yrys5/wearable-respiratory-monitoring-system/pcb/Manufacturing/main_controller-BOM.csv

Reference | Qty | Value | DNP | Exclude from BOM | Exclude from Board | Footprint | Datasheet | Distributor Link | Manufacturer | Manufacturer_Part_Number | Opis
AE1 | 1 | Antenna_Chip |  |  |  | SamacSys_Parts:ANT3216LL00R2400A | ~ | https://www.mouser.pl/ProductDetail/Pulse-Electronics/ANT3216LL00R2400A?qs=VAB4DzKv5wVywAIgVVebaA%3D%3D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 | Pulse Electronics | ANT3216LL00R2400A | Ceramic chip antenna with pin for PCB trace
C1,C2,C3,C4,C5,C6,C9,C10,C15,C16,C18,C21,C22,C23,C26,C27,C29,C30,C31 | 19 | 100n |  |  |  | Capacitor_SMD:C_0402_1005Metric | ~ | https://www.mouser.pl/ProductDetail/KYOCERA-AVX/04023C104KAT2A?qs=nNezP%252BoerbAsgsxxIAjFOw%3D%3D | KYOCERA AVX | 04023C104KAT2A | Unpolarized capacitor
C7,C8,C32,C33 | 4 | 4u7 |  |  |  | Capacitor_SMD:C_0603_1608Metric | ~ | https://www.mouser.pl/ProductDetail/KYOCERA-AVX/0603YD475MAT2A?qs=XLNwXgtzMM9JmbhKJE1Phg%3D%3D | KYOCERA AVX | 0603YD475MAT2A | Unpolarized capacitor
C11,C12 | 2 | 10p |  |  |  | Capacitor_SMD:C_0402_1005Metric | ~ | https://www.mouser.pl/ProductDetail/KYOCERA-AVX/04025A100JAT4A?qs=ZwvTZoB9SO9xQJ735IqqZg%3D%3D | KYOCERA AVX | 04025A100JAT4A | Unpolarized capacitor
C13 | 1 | NF |  |  |  | Capacitor_SMD:C_0402_1005Metric | ~ | https://www.mouser.pl/ProductDetail/KYOCERA-AVX/04023A102KAT2A?qs=zIdJ9r3ONKRWf%2FnwhLKx7Q%3D%3D | KYOCERA AVX | 04023A102KAT2A | Unpolarized capacitor
C14 | 1 | 1p2 |  |  |  | Capacitor_SMD:C_0402_1005Metric | ~ | https://www.mouser.pl/ProductDetail/KYOCERA-AVX/04025U1R2CAT2A?qs=ZwvTZoB9SO89N0yz92cnjQ%3D%3D | KYOCERA AVX | 04025U1R2CAT2A | Unpolarized capacitor
C17,C24 | 2 | 680p |  |  |  | Capacitor_SMD:C_0402_1005Metric | ~ | https://www.mouser.pl/ProductDetail/KYOCERA-AVX/KGM05ACG1H681JH?qs=Jm2GQyTW%2Fbi1QcZ9ve4RLw%3D%3D | KYOCERA AVX | KGM05ACG1H681JH | Unpolarized capacitor
C19,C20,C25,C28,C34 | 5 | 100p |  |  |  | Capacitor_SMD:C_0402_1005Metric | ~ | https://www.mouser.pl/ProductDetail/KYOCERA-AVX/KGM05ACG1E101JH?qs=OcgtsXO%252B3gsKy01JU7hIlA%3D%3D | KYOCERA AVX | KGM05ACG1E101JH | Unpolarized capacitor
FL1 | 1 | MLPF-WB55-01E3 |  |  |  | SamacSys_Parts:BUMPLESS_CSP_2025 | https://www.st.com/resource/en/datasheet/mlpf-wb55-01e3.pdf | https://www.mouser.pl/ProductDetail/STMicroelectronics/MLPF-WB55-01E3?qs=vLWxofP3U2xV%2FkxL9PmCDA%3D%3D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 | STMicroelectronics | MLPF-WB55-01E3 | 2.4 GHz low pass filter matched to STM32WB55Cx/Rx, STM32WB50Cx, STM32WB35Cx and STM32WB30Cx
FM1,FM2,FM3,FM4,FM5,FM6 | 6 | Fiducial |  | Excluded from BOM |  | Fiducial:Fiducial_1mm_Mask2mm | ~ |  |  |  | Fiducial Marker
IC1,IC2 | 2 | NAU7802SGI |  |  |  | SamacSys_Parts:SOIC127P600X175-16N | https://www.nuvoton.com/resource-files/NAU7802%20Data%20Sheet%20V1.7.pdf | https://www.mouser.pl/ProductDetail/Nuvoton/NAU7802SGI?qs=A6eO%252BMLsxmSrxisJRahwRQ%3D%3D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 | Nuvoton | NAU7802SGI | 24 Bit Analog to Digital Converter 2 Input 1 Sigma-Delta 16-SOP
IC6 | 1 | USBLC6-2SC6 |  |  |  | SamacSys_Parts:SOT95P280X145-6N | https://www.st.com/resource/en/datasheet/usblc6-2.pdf | https://www.mouser.pl/ProductDetail/STMicroelectronics/USBLC6-2SC6?qs=po45yt2pPpu%2FhNIlwQdTlg%3D%3D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 | STMicroelectronics | USBLC6-2SC6 | TVS Diode Array Uni-Directional USBLC6-2SC6 17V, SOT-23 6-Pin
J1 | 1 | USB_C_16P |  |  |  | Connector_USB:USB_C_Receptacle_GCT_USB4105-xx-A_16P_TopMnt_Horizontal | https://www.usb.org/sites/default/files/documents/usb_type-c.zip | https://www.mouser.pl/ProductDetail/GCT/USB4105-GF-A?qs=KUoIvG%2F9IlY%2FMLlBMpStpA%3D%3D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 | GCT | USB4105-GF-A | USB 2.0-only 16P Type-C Receptacle connector
J2 | 1 | TC2030 |  | Excluded from BOM |  | Connector:Tag-Connect_TC2030-IDC-FP_2x03_P1.27mm_Vertical | https://www.tag-connect.com/wp-content/uploads/bsk-pdf-manager/TC2030-CTX_1.pdf |  |  |  | Tag-Connect ARM Cortex SWD JTAG connector, 6 pin
J3,J4 | 2 | Screw_01x04 |  |  |  | SamacSys_Parts:2828374 | ~ | https://www.mouser.pl/ProductDetail/TE-Connectivity/282837-4?qs=A%252Bip%252BNCYi6MiQzbqNH27Ug%3D%3D | TE Connectivity | 282837-4 | Generic screw terminal, single row, 01x04, script generated (kicad-library-utils/schlib/autogen/connector/)
L1 | 1 | 3n6 |  |  |  | Inductor_SMD:L_0402_1005Metric | ~ | https://www.mouser.pl/ProductDetail/Murata-Electronics/LQG15HH3N6S02D?qs=%2F%252BYoplLUB5gB2r1QYGu9rQ%3D%3D | Murata Electronics | LQG15HH3N6S02D | Inductor
LED1 | 1 | BLUE |  |  |  | LED_SMD:LED_0603_1608Metric | ~ | https://www.mouser.pl/ProductDetail/Wurth-Elektronik/150040BS73240?qs=fAHHVMwC%252BbhvR%252BdBIVVrgw%3D%3D | Wurth Elektronik | 150040BS73240 | Light emitting diode
LED2 | 1 | GREEN |  |  |  | LED_SMD:LED_0603_1608Metric | ~ | https://www.mouser.pl/ProductDetail/Wurth-Elektronik/150040GS73240?qs=fAHHVMwC%252Bbgmx0FZHKuCJg%3D%3D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 | Wurth Elektronik | 150040GS73240 | Light emitting diode
LED3 | 1 | RED |  |  |  | LED_SMD:LED_0603_1608Metric | ~ | https://www.mouser.pl/ProductDetail/Wurth-Elektronik/150040RS73240?qs=8Aam6%252B7C6HGMiInmnlrBiw%3D%3D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 | Wurth Elektronik | 150040RS73240 | Light emitting diode
R1 | 1 | 2k |  |  |  | Resistor_SMD:R_0402_1005Metric | ~ | https://www.mouser.pl/ProductDetail/YAGEO/RC0402JR-072KP?qs=qpJ%252B%252B%252Bdg6p0PgyEL%2F3YtPQ%3D%3D | YAGEO | RC0402JR-072KP | Resistor
R2,R4 | 2 | 5k1 |  |  |  | Resistor_SMD:R_0402_1005Metric | ~ | https://www.mouser.pl/ProductDetail/YAGEO/RC0402FR-075K1L?qs=YUgVZYePFqCSmQuaha43RA%3D%3D | YAGEO | RC0402FR-075K1L | Resistor
R3,R6,R14,R15,R16,R17 | 6 | 100 |  |  |  | Resistor_SMD:R_0402_1005Metric | ~ | https://www.mouser.pl/ProductDetail/YAGEO/RC0402FR-7D100RL?qs=HEu%2FF%2FCqxzJsiV2ODdo2Ug%3D%3D | YAGEO | RC0402FR-7D100RL | Resistor
R5,R7,R11,R12 | 4 | 51 |  |  |  | Resistor_SMD:R_0402_1005Metric | ~ | https://www.mouser.pl/ProductDetail/YAGEO/RC0402FR-0751RL?qs=tJ7dZ%2FiRbl1ePfckivGc%252Bg%3D%3D | YAGEO | RC0402FR-0751RL | Resistor
R8,R9,R10,R13 | 4 | 0 |  |  |  | Resistor_SMD:R_0402_1005Metric | ~ | https://www.mouser.pl/ProductDetail/YAGEO/RC0402JR-7D0RL?qs=HEu%2FF%2FCqxzIQvs7MZn9nkA%3D%3D | YAGEO | RC0402JR-7D0RL | Resistor
U1 | 1 | STM32WB55CGU6 |  |  |  | Package_DFN_QFN:QFN-48-1EP_7x7mm_P0.5mm_EP5.6x5.6mm | https://www.st.com/resource/en/datasheet/stm32wb55cg.pdf | https://www.mouser.pl/ProductDetail/STMicroelectronics/STM32WB55CGU6?qs=lYGu3FyN48eI3bRY%252B36gew%3D%3D | STMicroelectronics | STM32WB55CGU6 | STMicroelectronics Arm Cortex-M4 MCU, 1024KB flash, 256KB RAM, 64 MHz, 1.71-3.6V, 30 GPIO, UFQFPN48
U2 | 1 | MIC5365-3.3YD5 |  |  |  | Package_TO_SOT_SMD:TSOT-23-5 | https://ww1.microchip.com/downloads/aemDocuments/documents/APID/ProductDocuments/DataSheets/MIC5365-6-High-Performance-Single-150mA-LDO-DS20006605A.pdf | https://www.mouser.pl/ProductDetail/Microchip-Technology/MIC5365-3.3YD5-TR?qs=U6T8BxXiZAXzRinbbfZRrg%3D%3D | Microchip Technology | MIC5365-3.3YD5-TR | 150mA Low-dropout Voltage Regulator, Vout 3.3V, Vin up to 5.5V, TSOT-23-5
X1 | 1 | 32kHz768 |  |  |  | Crystal:Crystal_SMD_2012-2Pin_2.0x1.2mm | ~ | https://www.mouser.pl/ProductDetail/NDK/NX2012SA-32.768K-STD-MUB-1?qs=55YtniHzbhA%252B6%2Fl1MwFZaQ%3D%3D | NDK | NX2012SA-32.768K-STD-MUB-1 | Two pin crystal
X2 | 1 | 32MHz |  |  |  | Crystal:Crystal_SMD_2016-4Pin_2.0x1.6mm | ~ | https://www.mouser.pl/ProductDetail/NDK/NX2016SA-32M-EXS00A-CS06465?qs=w%2Fv1CP2dgqr82b0JjRnv4A%3D%3D | NDK | NX2016SA-32M-EXS00A-CS06465 | Four pin crystal, GND on pins 2 and 4
