yrys5/wearable-respiratory-monitoring-system/3d-models/LoadcellHook.FCStd

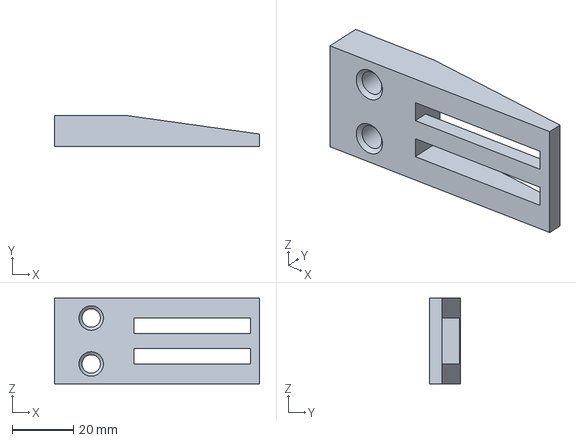
[picture p1: CAD file, 2026-10-22]
3d-models/LoadcellHook.FCStd
67.0 x 10.0 x 28.0 mm
