yrys5/wearable-respiratory-monitoring-system/3d-models/DeviceCaseBack_v2.FCStd

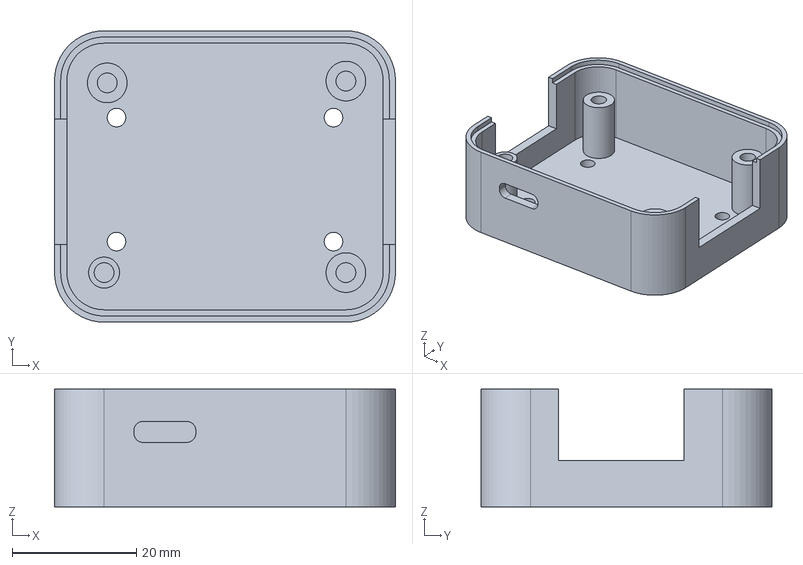
[picture p2: CAD file, 2026-10-22]
3d-models/DeviceCaseBack_v2.FCStd
55.0 x 47.0 x 19.0 mm
