yrys5/wearable-respiratory-monitoring-system/3d-models/LoadcellBack.FCStd

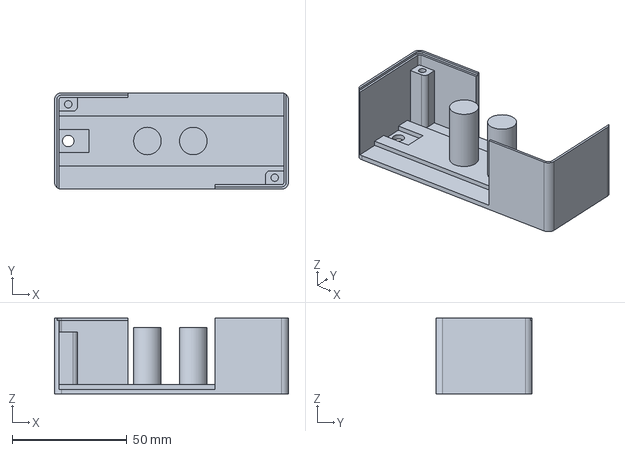
[picture p3: CAD file, 2026-10-22]
3d-models/LoadcellBack.FCStd
102.0 x 42.0 x 33.0 mm
