yrys5/wearable-respiratory-monitoring-system/3d-models/DeviceCaseFront_v2.FCStd

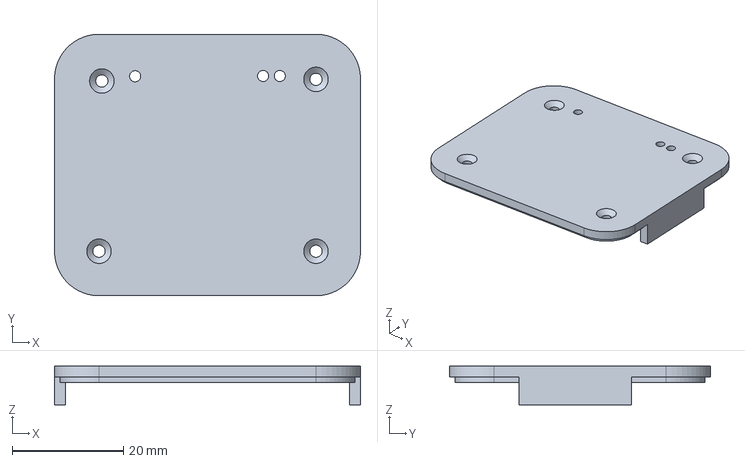
[picture p4: CAD file, 2026-10-22]
3d-models/DeviceCaseFront_v2.FCStd
55.0 x 47.0 x 7.00 mm
