yrys5/wearable-respiratory-monitoring-system/3d-models/LoadcellTop-Body.stl

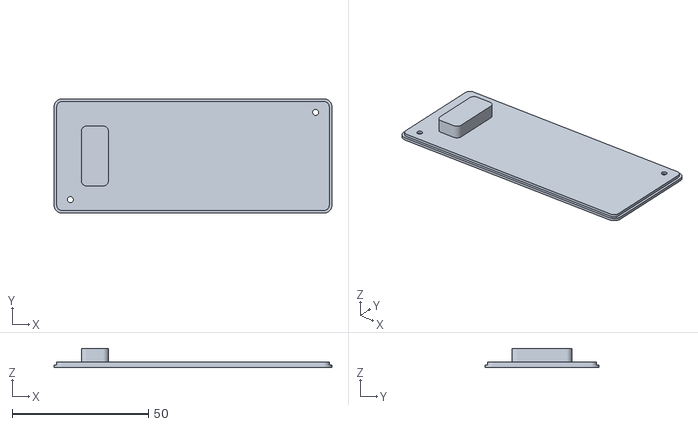
[picture p5: CAD file, 2026-10-22]
3d-models/LoadcellTop-Body.stl
102.0 x 42.0 x 7.00
