yrys5/wearable-respiratory-monitoring-system/(list of files, cad)

Other CAD files:
3d-models/LoadcellHook-Body.stl
3d-models/LoadcellBack-Body.stl
3d-models/DeviceCaseBack_v2-Body005.stl
3d-models/LoadcellTop.FCStd
3d-models/DeviceCaseFront_v2-Body006.stl
