yrys5/wearable-respiratory-monitoring-system/pcb/main_controller.kicad_pcb

## KiCad design pcb/main_controller.kicad_pcb (2026-10-22)

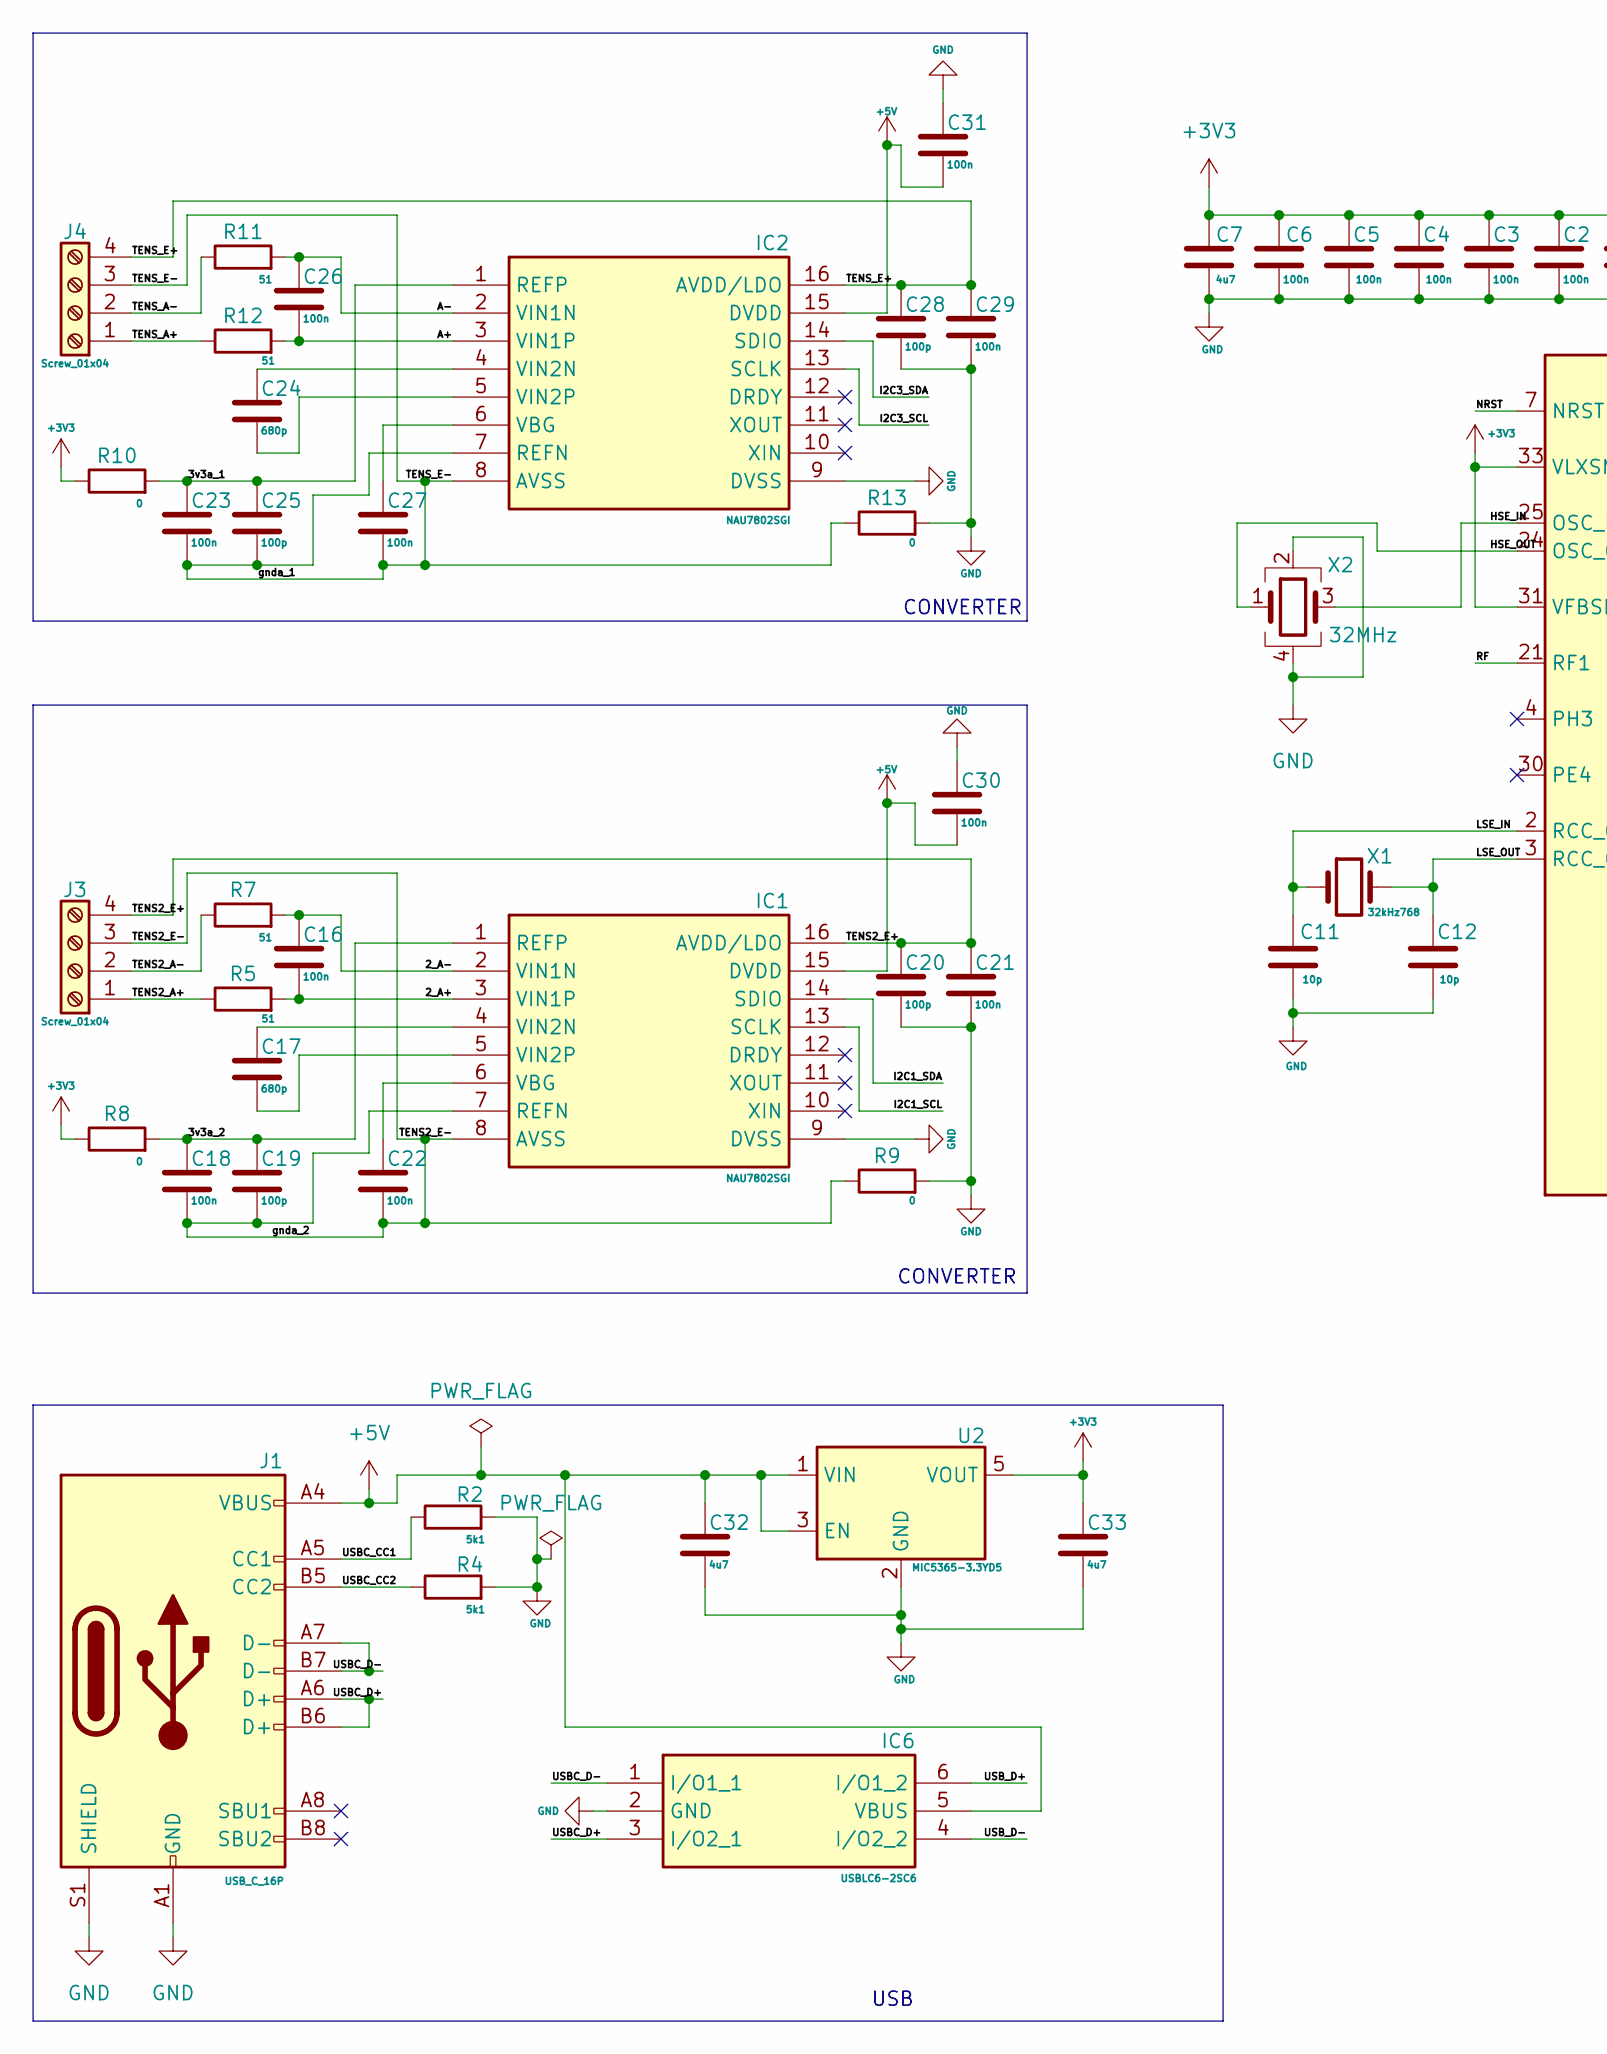
[picture p6: schematic main_controller.kicad_sch, part in row 1, column 1]

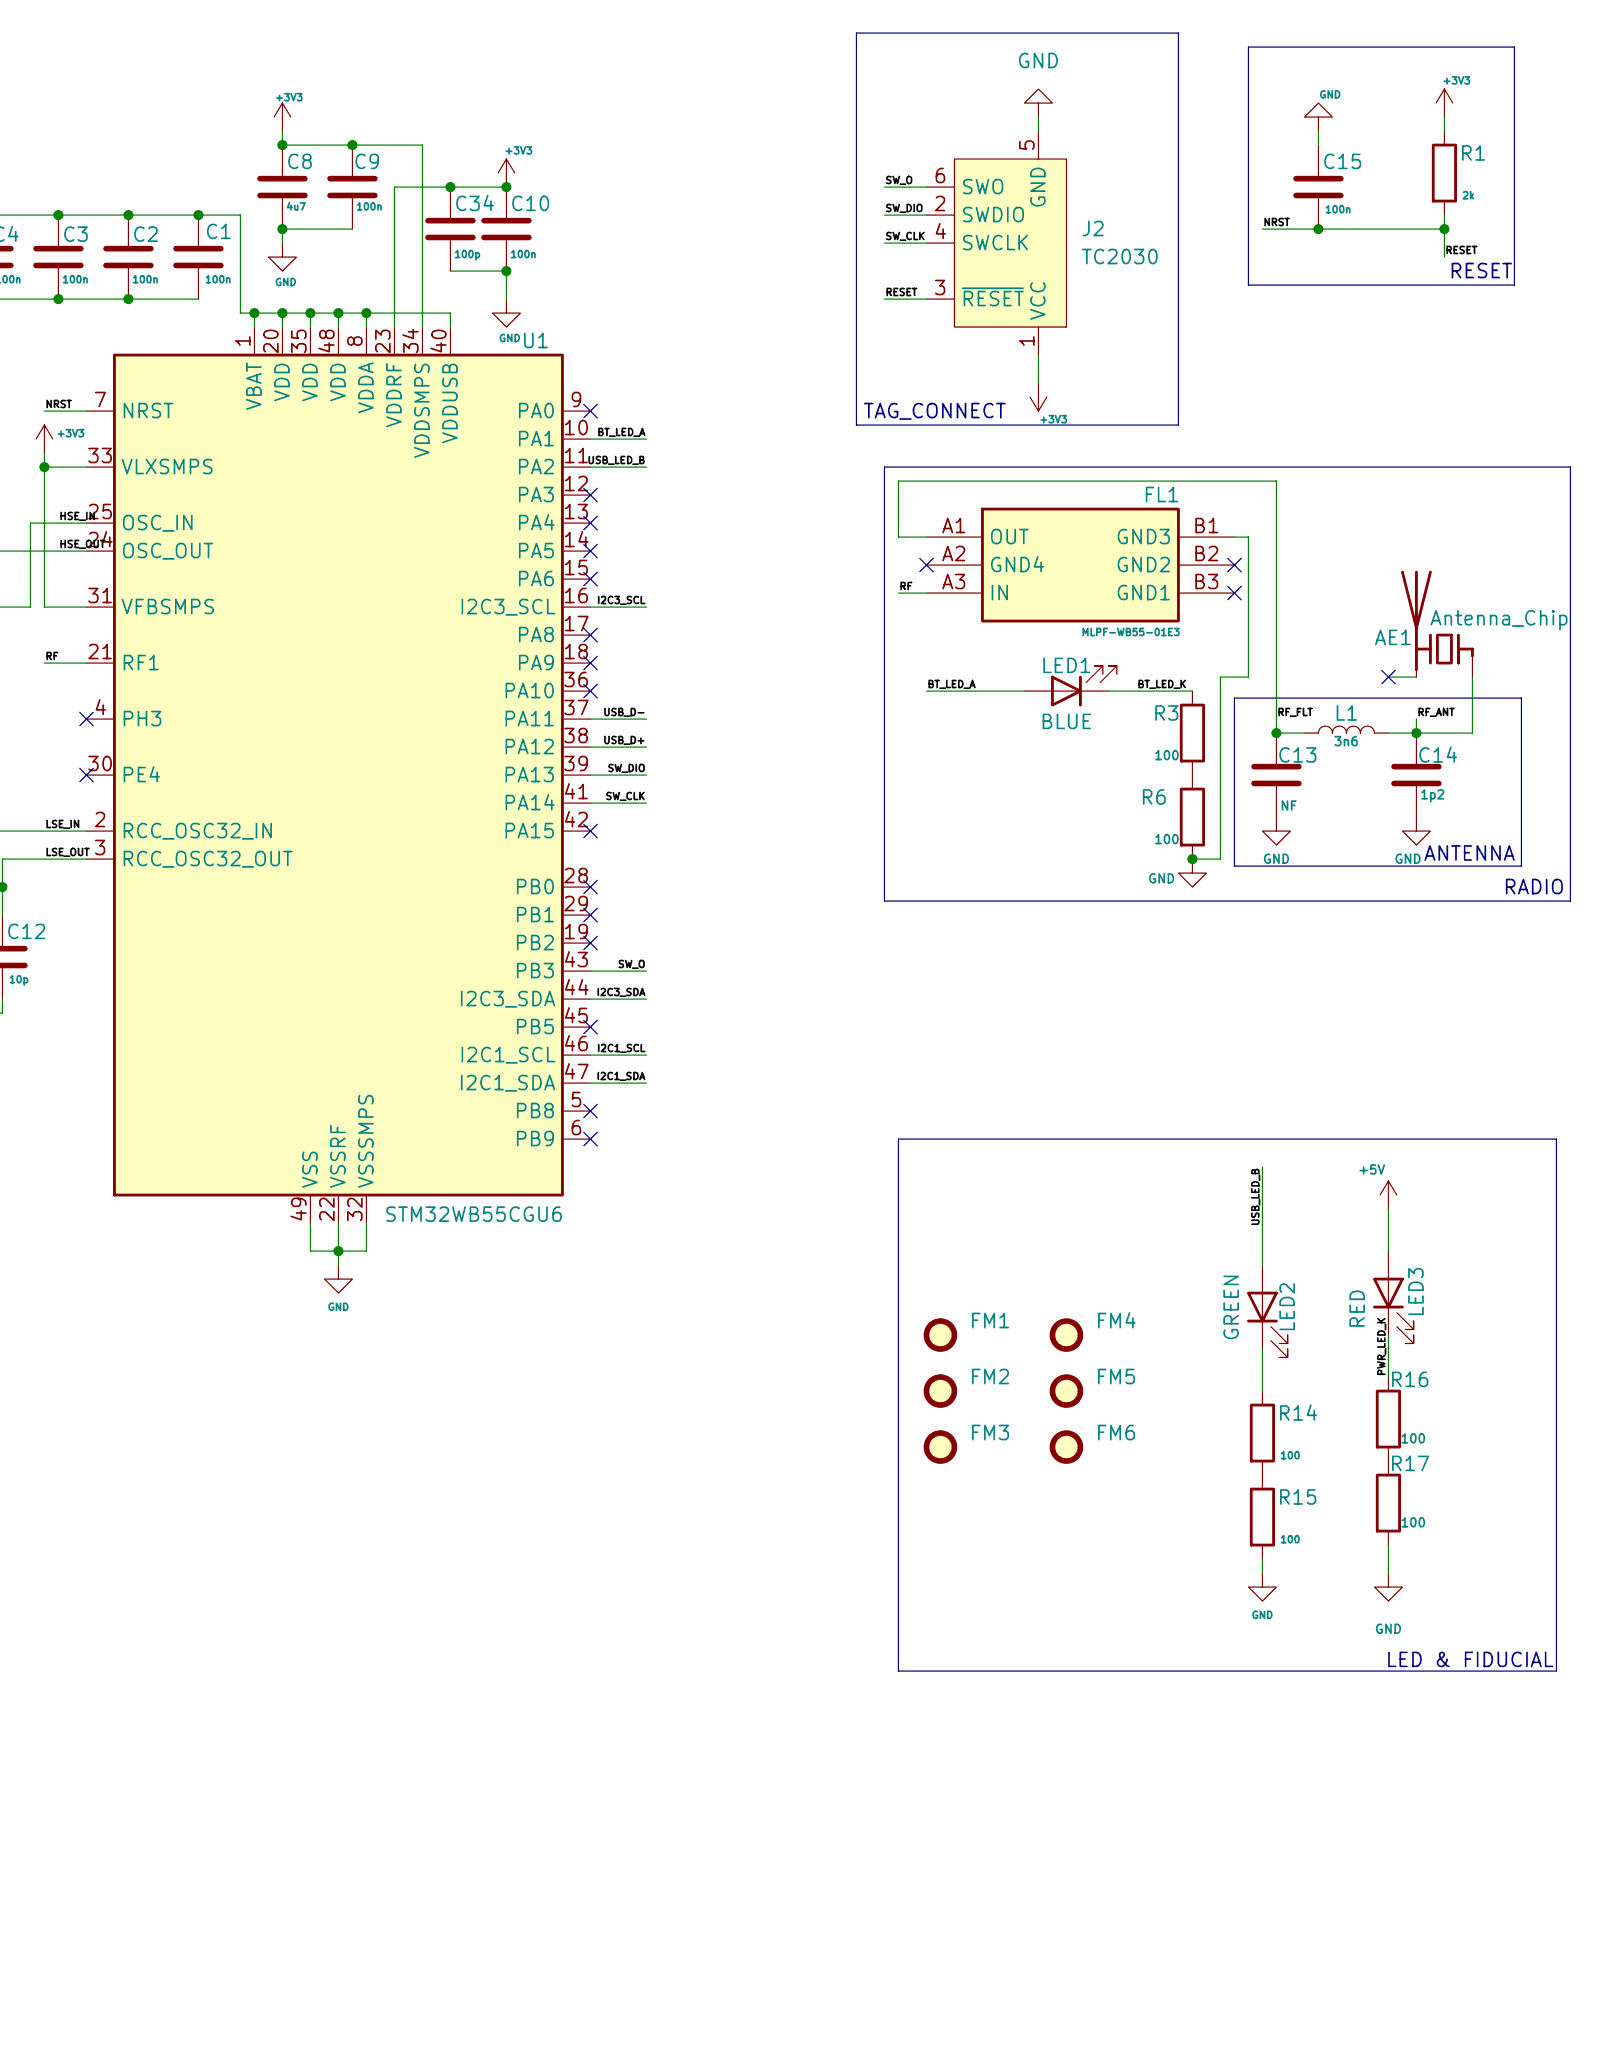
[picture p7: schematic main_controller.kicad_sch, part in row 1, column 2]

Parts:
AE1: Antenna_Chip; ANT3216LL00R2400A; Manufacturer_Part_Number ANT3216LL00R2400A
C1, C2, C3, C4, C5, C6, C9, C10, C15, C16, C18, C21, C22, C23, C26, C27, C29, C30, C31: 100n; C_0402_1005Metric; Manufacturer_Part_Number 04023C104KAT2A
C7, C8, C32, C33: 4u7; C_0603_1608Metric; Manufacturer_Part_Number 0603YD475MAT2A
C11, C12: 10p; C_0402_1005Metric; Manufacturer_Part_Number 04025A100JAT4A
C13: NF; C_0402_1005Metric; Manufacturer_Part_Number 04023A102KAT2A
C14: 1p2; C_0402_1005Metric; Manufacturer_Part_Number 04025U1R2CAT2A; DigiKey Number 490-6210-1-ND
C17, C24: 680p; C_0402_1005Metric; Manufacturer_Part_Number KGM05ACG1H681JH
C19, C20, C25, C28, C34: 100p; C_0402_1005Metric; Manufacturer_Part_Number KGM05ACG1E101JH
FL1: MLPF-WB55-01E3; BUMPLESS_CSP_2025; Mouser Part Number 511-MLPF-WB55-01E3
FM1, FM2, FM3, FM4, FM5, FM6: Fiducial; Fiducial_1mm_Mask2mm
IC1, IC2: NAU7802SGI; SOIC127P600X175-16N; Manufacturer_Part_Number NAU7802SGI
IC6: USBLC6-2SC6; SOT95P280X145-6N; Mouser Part Number 511-USBLC6-2SC6
J1: USB_C_16P; USB_C_Receptacle_GCT_USB4105-xx-A_16P_TopMnt_Horizontal; Manufacturer_Part_Number USB4105-GF-A
J2: TC2030; Tag-Connect_TC2030-IDC-FP_2x03_P1.27mm_Vertical
J3, J4: Screw_01x04; 2828374; Manufacturer_Part_Number 282837-4
L1: 3n6; L_0402_1005Metric; Manufacturer_Part_Number LQG15HH3N6S02D; DigiKey Number 490-6571-1-ND
LED1: BLUE; LED_0603_1608Metric; Manufacturer_Part_Number 150040BS73240
LED2: GREEN; LED_0603_1608Metric; Manufacturer_Part_Number 150040GS73240
LED3: RED; LED_0603_1608Metric; Manufacturer_Part_Number 150040RS73240; DigiKey Number 160-1447-1-ND
R1: 2k; R_0402_1005Metric; Manufacturer_Part_Number RC0402JR-072KP
R2, R4: 5k1; R_0402_1005Metric; Manufacturer_Part_Number RC0402FR-075K1L
R3, R6, R16, R17: 100; R_0402_1005Metric; Manufacturer_Part_Number RC0402FR-7D100RL; DigiKey Number 311-100JRCT-ND
R5, R7, R11, R12: 51; R_0402_1005Metric; Manufacturer_Part_Number RC0402FR-0751RL
R8, R9, R10, R13: 0; R_0402_1005Metric; Manufacturer_Part_Number RC0402JR-7D0RL
R14, R15: 100; R_0402_1005Metric; Manufacturer_Part_Number RC0402FR-7D100RL
U1: STM32WB55CGU6; QFN-48-1EP_7x7mm_P0.5mm_EP5.6x5.6mm; Manufacturer_Part_Number STM32WB55CGU6
U2: MIC5365-3.3YD5; TSOT-23-5; Manufacturer_Part_Number MIC5365-3.3YD5-TR
X1: 32kHz768; Crystal_SMD_2012-2Pin_2.0x1.2mm; Manufacturer_Part_Number NX2012SA-32.768K-STD-MUB-1
X2: 32MHz; Crystal_SMD_2016-4Pin_2.0x1.6mm; Manufacturer_Part_Number NX2016SA-32M-EXS00A-CS06465

Connections:
+3V3: C1.1, C2.1, C3.1, C4.1, C5.1, C6.1, C7.1, C8.1, C9.1, C10.1, C33.1, C34.1, J2.1 (VCC), R1.1, R8.1, R10.1, U1.1 (VBAT), U1.8 (VDDA), U1.20 (VDD), U1.23 (VDDRF), U1.31 (VFBSMPS), U1.33 (VLXSMPS), U1.34 (VDDSMPS), U1.35 (VDD), U1.40 (VDDUSB), U1.48 (VDD), U2.5 (VOUT)
+5V: C30.2, C31.2, C32.1, IC1.15 (DVDD), IC2.15 (DVDD), IC6.5 (VBUS), J1.A4 (VBUS), J1.A9 (VBUS), J1.B4 (VBUS), J1.B9 (VBUS), LED3.2 (A), U2.1 (VIN), U2.3 (EN)
/2_A+: C16.2, IC1.3 (VIN1P), R5.2
/2_A-: C16.1, IC1.2 (VIN1N), R7.2
/3v3a_1: C23.1, C25.1, IC2.1 (REFP), R10.2
/3v3a_2: C18.1, C19.1, IC1.1 (REFP), R8.2
/A+: C26.2, IC2.3 (VIN1P), R12.2
/A-: C26.1, IC2.2 (VIN1N), R11.2
/BT_LED_A: LED1.2 (A), U1.10 (PA1)
/BT_LED_K: LED1.1 (K), R3.1
/HSE_IN: U1.25 (OSC_IN), X2.3
/HSE_OUT: U1.24 (OSC_OUT), X2.1
/I2C1_SCL: IC1.13 (SCLK), U1.46 (I2C1_SCL)
/I2C1_SDA: IC1.14 (SDIO), U1.47 (I2C1_SDA)
/I2C3_SCL: IC2.13 (SCLK), U1.16 (I2C3_SCL)
/I2C3_SDA: IC2.14 (SDIO), U1.44 (I2C3_SDA)
/LSE_IN: C11.1, U1.2 (RCC_OSC32_IN), X1.1
/LSE_OUT: C12.1, U1.3 (RCC_OSC32_OUT), X1.2
/NRST: C15.2, J2.3 (~RESET), R1.2, U1.7 (NRST)
/PWR_LED_K: LED3.1 (K), R16.1
/RF: FL1.A3 (IN), U1.21 (RF1)
/RF_ANT: AE1.1 (FEED), C14.1, L1.2
/RF_FLT: C13.1, FL1.A1 (OUT), L1.1
/SW_CLK: J2.4 (SWCLK), U1.41 (PA14)
/SW_DIO: J2.2 (SWDIO), U1.39 (PA13)
/SW_O: J2.6 (SWO), U1.43 (PB3)
/TENS2_A+: J3.1, R5.1
/TENS2_A-: J3.2, R7.1
/TENS2_E+: C20.1, C21.1, IC1.16 (AVDD/LDO), J3.4
/TENS2_E-: C18.2, C19.2, C22.2, IC1.7 (REFN), IC1.8 (AVSS), J3.3, R9.1
/TENS_A+: J4.1, R12.1
/TENS_A-: J4.2, R11.1
/TENS_E+: C28.1, C29.1, IC2.16 (AVDD/LDO), J4.4
/TENS_E-: C23.2, C25.2, C27.2, IC2.7 (REFN), IC2.8 (AVSS), J4.3, R13.1
/USBC_CC1: J1.A5 (CC1), R2.1
/USBC_CC2: J1.B5 (CC2), R4.1
/USBC_D+: IC6.3 (I/O2_1), J1.A6 (D+), J1.B6 (D+)
/USBC_D-: IC6.1 (I/O1_1), J1.A7 (D-), J1.B7 (D-)
/USB_D+: IC6.6 (I/O1_2), U1.38 (PA12)
/USB_D-: IC6.4 (I/O2_2), U1.37 (PA11)
GND: C1.2, C2.2, C3.2, C4.2, C5.2, C6.2, C7.2, C8.2, C9.2, C10.2, C11.2, C12.2, C13.2, C14.2, C15.1, C20.2, C21.2, C28.2, C29.2, C30.1, C31.1, C32.2, C33.2, C34.2, FL1.B1 (GND3), IC1.9 (DVSS), IC2.9 (DVSS), IC6.2 (GND), J1.A1 (GND), J1.A12 (GND), J1.B1 (GND), J1.B12 (GND), J1.S1 (SHIELD), J2.5 (GND), R2.2, R4.2, R6.2, R9.2, R13.2, R15.2, R17.2, U1.22 (VSSRF), U1.32 (VSSSMPS), U1.49 (VSS), U2.2 (GND), X2.2, X2.4
unnamed: C22.1, IC1.6 (VBG)
unnamed: C17.1, IC1.4 (VIN2N)
unnamed: C17.2, IC1.5 (VIN2P)
unnamed: C27.1, IC2.6 (VBG)
unnamed: C24.1, IC2.4 (VIN2N)
unnamed: C24.2, IC2.5 (VIN2P)
unnamed: LED2.2 (A), U1.11 (PA2)
unnamed: LED2.1 (K), R14.1
unnamed: R3.2, R6.1
unnamed: R14.2, R15.1
unnamed: R16.2, R17.1

Notes on the sheet:
RADIO
CONVERTER
ANTENNA
TAG_CONNECT
RESET
USB
LED & FIDUCIAL

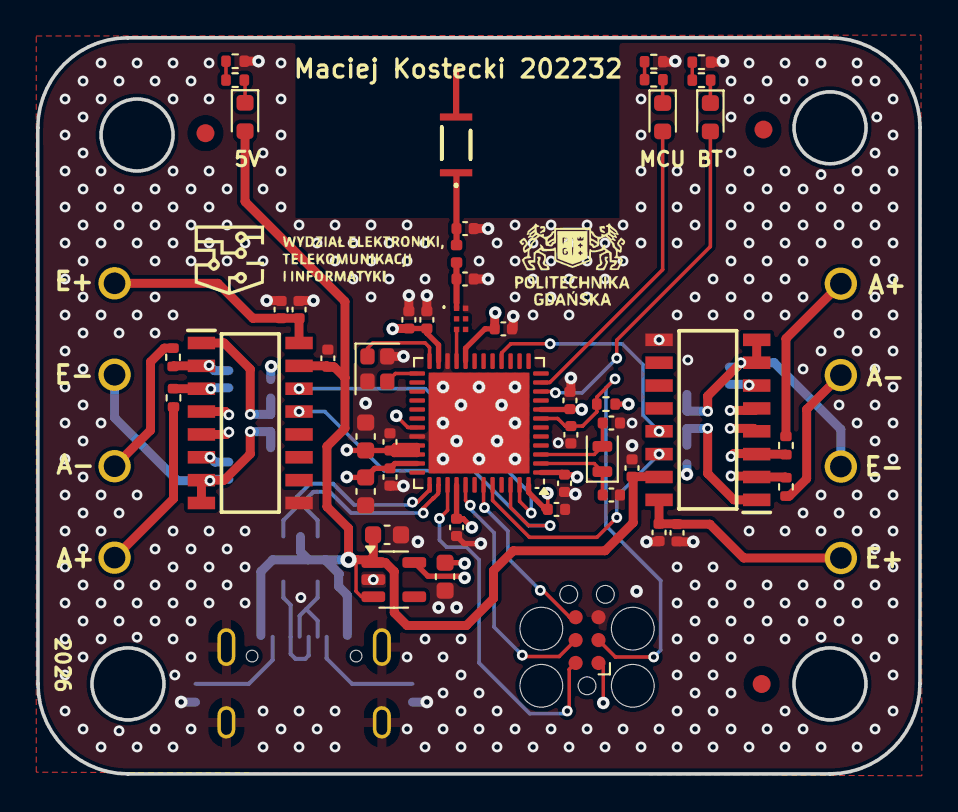
[picture p8: board main_controller.kicad_pcb from above]

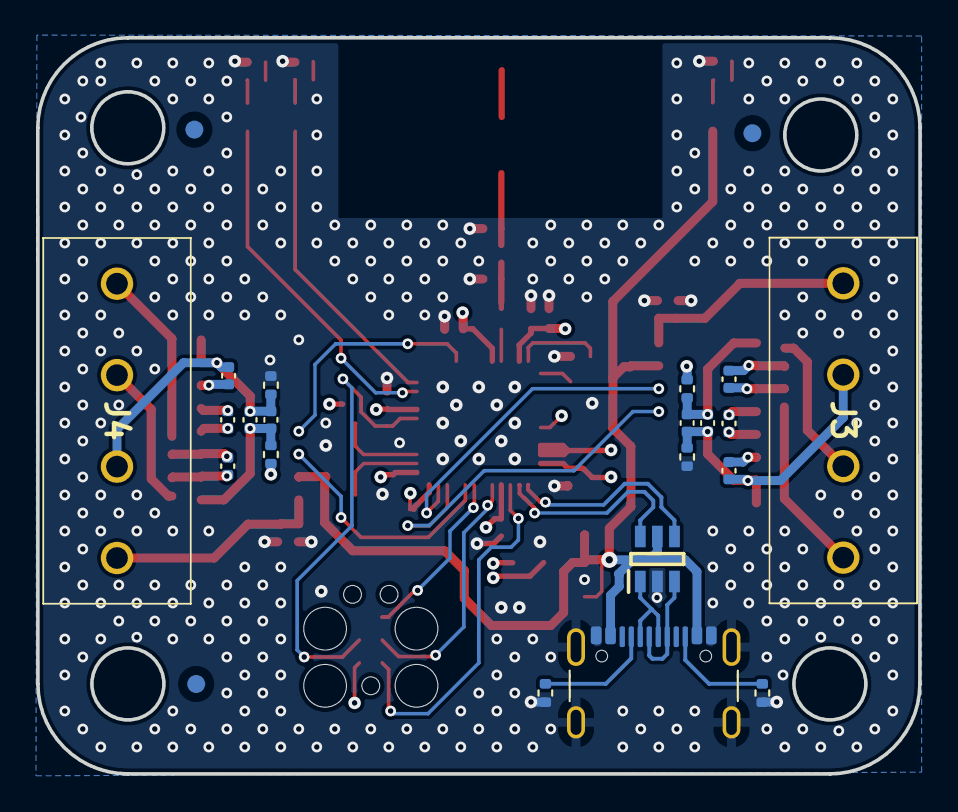
[picture p9: board main_controller.kicad_pcb from below]

Board: 4 copper layers, 49.0 x 40.9 mm, 74 parts (23 on the bottom side), 52 nets.
