yrys5/wearable-respiratory-monitoring-system/firmware/Src/main.c

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
/* Includes ------------------------------------------------------------------*/
#include "main.h"
#include "usb_device.h"

/* USER CODE BEGIN Includes */
#include "nau7802.h"
#include "custom_app.h"
/* USER CODE END Includes */

I2C_HandleTypeDef hi2c1;
I2C_HandleTypeDef hi2c3;

IPCC_HandleTypeDef hipcc;

RTC_HandleTypeDef hrtc;

/* USER CODE BEGIN PV */
NAU7802_HandleTypeDef nau1;
NAU7802_HandleTypeDef nau2;

int32_t nau1_raw = 0;
int32_t nau2_raw = 0;

uint8_t nau1_ok = 0;
uint8_t nau2_ok = 0;

volatile uint32_t nau1_read_ok_count = 0;
volatile uint32_t nau2_read_ok_count = 0;

volatile uint32_t nau1_read_error_count = 0;
volatile uint32_t nau2_read_error_count = 0;

volatile uint32_t nau1_not_ready_count = 0;
volatile uint32_t nau2_not_ready_count = 0;

volatile uint32_t main_loop_count = 0;

volatile uint32_t nau1_last_read_tick = 0;
volatile uint32_t nau2_last_read_tick = 0;

volatile uint32_t nau1_last_ok_tick = 0;
volatile uint32_t nau2_last_ok_tick = 0;

volatile uint32_t send_last_tick = 0;

static uint32_t consumed_ch1_count = 0;
static uint32_t consumed_ch2_count = 0;
//NAU7802_HandleTypeDef nau1;
//NAU7802_HandleTypeDef nau2;
//
//int32_t nau1_raw = 0;
//int32_t nau2_raw = 0;
//
//uint8_t nau1_ok = 0;
//uint8_t nau2_ok = 0;
//
//volatile uint32_t nau1_read_ok_count = 0;
//volatile uint32_t nau2_read_ok_count = 0;
//volatile uint32_t nau1_read_error_count = 0;
//volatile uint32_t nau2_read_error_count = 0;
//volatile uint32_t nau1_not_ready_count = 0;
//volatile uint32_t main_loop_count = 0;
//volatile uint32_t nau1_last_read_tick = 0;
//volatile uint32_t nau1_last_ok_tick = 0;
/* USER CODE END PV */

void SystemClock_Config(void);
void PeriphCommonClock_Config(void);
static void MX_GPIO_Init(void);
static void MX_I2C1_Init(void);
static void MX_I2C3_Init(void);
static void MX_IPCC_Init(void);
static void MX_RTC_Init(void);
static void MX_RF_Init(void);
/**
  * @brief  The application entry point.
  * @retval int
  */
int main(void)
{

  /* MCU Configuration--------------------------------------------------------*/

  /* Reset of all peripherals, Initializes the Flash interface and the Systick. */
  HAL_Init();
  /* Config code for STM32_WPAN (HSE Tuning must be done before system clock configuration) */
  MX_APPE_Config();

  /* Configure the system clock */
  SystemClock_Config();

  /* Configure the peripherals common clocks */
  PeriphCommonClock_Config();

  /* IPCC initialisation */
  MX_IPCC_Init();

  /* Initialize all configured peripherals */
  MX_GPIO_Init();
  MX_I2C1_Init();
  MX_I2C3_Init();
  MX_RTC_Init();
  MX_USB_Device_Init();
  MX_RF_Init();
  /* USER CODE BEGIN 2 */
  HAL_Delay(100);

  /*
   * ADC 1 - I2C1
   */
  if (NAU7802_Init(&nau1, &hi2c1) == NAU7802_OK)
  {
      nau1_ok = 1;
      NAU7802_DumpRegisters(&nau1);
  }
  else
  {
      nau1_ok = 0;
  }
  if (NAU7802_Init(&nau2, &hi2c3) == NAU7802_OK)
  {
      nau2_ok = 1;
      NAU7802_DumpRegisters(&nau2);
  }
  else
  {
      nau2_ok = 0;
  }
  /* USER CODE END 2 */

  /* Init code for STM32_WPAN */
  MX_APPE_Init();

  /* Infinite loop */
  /* USER CODE BEGIN WHILE */
  while (1)
  {
	     if ((HAL_GetTick() - nau1_last_read_tick) >= 100)
	     {
	         nau1_last_read_tick = HAL_GetTick();

	         if (nau1_ok)
	         {
	             NAU7802_Status result = NAU7802_ReadRawBlocking(&nau1, &nau1_raw, 50);

	             if (result == NAU7802_OK)
	             {
	                 nau1_read_ok_count++;
	                 nau1_last_ok_tick = HAL_GetTick();

	             }
	             else if (result == NAU7802_NOT_READY || result == NAU7802_TIMEOUT)
	             {
	                 nau1_not_ready_count++;
	             }
	             else
	             {
	                 nau1_read_error_count++;
	             }
	         }
	     }
		  if ((HAL_GetTick() - nau2_last_read_tick) >= 100)
		  {
		      nau2_last_read_tick = HAL_GetTick();

		      if (nau2_ok)
		      {
		          NAU7802_Status result = NAU7802_ReadRawBlocking(&nau2, &nau2_raw, 50);

		          if (result == NAU7802_OK)
		          {
		              nau2_read_ok_count++;
		              nau2_last_ok_tick = HAL_GetTick();

		          }
		          else if (result == NAU7802_NOT_READY || result == NAU7802_TIMEOUT)
		          {
		              nau2_not_ready_count++;
		          }
		          else
		          {
		              nau2_read_error_count++;
		          }
		      }
		  }
		  if ((HAL_GetTick() - send_last_tick) >= 100)
		  {
		      send_last_tick = HAL_GetTick();
              if(nau1_ok && nau2_ok &&
                 nau1_read_ok_count != consumed_ch1_count &&
                 nau2_read_ok_count != consumed_ch2_count) {
                  Custom_APP_SendAdcValue(nau1_raw, nau2_raw);
              } else {
                  Custom_APP_AdcGap();
              }
              consumed_ch1_count = nau1_read_ok_count;
              consumed_ch2_count = nau2_read_ok_count;
		  }
    /* USER CODE END WHILE */
    MX_APPE_Process();

    /* USER CODE BEGIN 3 */
    Custom_APP_Process();
  }
  /* USER CODE END 3 */
}

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
