yrys5/wearable-respiratory-monitoring-system/firmware/BA_WB_3.ioc

Mcu.UserName=STM32WB55CGUx
PA1.GPIO_Label=BL_LED_A
PA1.Signal=GPIO_Output
PA11.Signal=USB_DM
PA12.Signal=USB_DP
PA13.Signal=SYS_JTMS-SWDIO
PA14.Signal=SYS_JTCK-SWCLK
PA2.GPIO_Label=MCU_LED
PA2.Signal=GPIO_Output
PA7.Signal=I2C3_SCL
PB3.Signal=SYS_JTDO-SWO
PB4.Signal=I2C3_SDA
PB6.Signal=I2C1_SCL
PB7.Signal=I2C1_SDA
PC14-OSC32_IN.Signal=RCC_OSC32_IN
PC15-OSC32_OUT.Signal=RCC_OSC32_OUT
