yrys5/wearable-respiratory-monitoring-system/firmware/Inc/main.h

#define BL_LED_A_Pin GPIO_PIN_1
#define BL_LED_A_GPIO_Port GPIOA
#define MCU_LED_Pin GPIO_PIN_2
#define MCU_LED_GPIO_Port GPIOA
