yrys5/wearable-respiratory-monitoring-system/firmware/Src/custom_stm.c

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

/* Includes ------------------------------------------------------------------*/
#include "common_blesvc.h"
#include "custom_stm.h"

/* USER CODE BEGIN Includes */
#include "custom_app.h"
#include "main.h"
/* USER CODE END Includes */

typedef struct{
  uint16_t  CustomBaservHdle;                    /**< BrathingAnalyzerService handle */
  uint16_t  CustomBawb55Hdle;                  /**< BrathingAnalyzerWB55 handle */
/* USER CODE BEGIN Context */
  uint16_t ControlHdle;
/* USER CODE END Context */
}CustomContext_t;

extern uint16_t Connection_Handle;
#define UUID_128_SUPPORTED  1

#if (UUID_128_SUPPORTED == 1)
#define BM_UUID_LENGTH  UUID_TYPE_128
#else
#define BM_UUID_LENGTH  UUID_TYPE_16
#endif

#define BM_REQ_CHAR_SIZE    (3)

#define CHARACTERISTIC_DESCRIPTOR_ATTRIBUTE_OFFSET         2
#define CHARACTERISTIC_VALUE_ATTRIBUTE_OFFSET              1
uint16_t SizeBawb55 = 20;

/**
 * START of Section BLE_DRIVER_CONTEXT
 */
static CustomContext_t CustomContext;

/**
 * END of Section BLE_DRIVER_CONTEXT
 */

static SVCCTL_EvtAckStatus_t Custom_STM_Event_Handler(void *pckt);

static tBleStatus Generic_STM_App_Update_Char_Ext(uint16_t ConnectionHandle, uint16_t ServiceHandle, uint16_t CharHandle, uint16_t CharValueLen, uint8_t *pPayload);

/* Functions Definition ------------------------------------------------------*/

#define COPY_UUID_128(uuid_struct, uuid_15, uuid_14, uuid_13, uuid_12, uuid_11, uuid_10, uuid_9, uuid_8, uuid_7, uuid_6, uuid_5, uuid_4, uuid_3, uuid_2, uuid_1, uuid_0) \
do {\
    uuid_struct[0] = uuid_0; uuid_struct[1] = uuid_1; uuid_struct[2] = uuid_2; uuid_struct[3] = uuid_3; \
    uuid_struct[4] = uuid_4; uuid_struct[5] = uuid_5; uuid_struct[6] = uuid_6; uuid_struct[7] = uuid_7; \
    uuid_struct[8] = uuid_8; uuid_struct[9] = uuid_9; uuid_struct[10] = uuid_10; uuid_struct[11] = uuid_11; \
    uuid_struct[12] = uuid_12; uuid_struct[13] = uuid_13; uuid_struct[14] = uuid_14; uuid_struct[15] = uuid_15; \
}while(0)

#define COPY_BRATHINGANALYZERSERVICE_UUID(uuid_struct)          COPY_UUID_128(uuid_struct,0x00,0x00,0x00,0x00,0xcc,0x7a,0x48,0x2a,0x98,0x4a,0x7f,0x2e,0xd5,0xb3,0xe5,0x8f)
#define COPY_BRATHINGANALYZERWB55_UUID(uuid_struct)    COPY_UUID_128(uuid_struct,0x00,0x00,0xa0,0x01,0x8e,0x22,0x45,0x41,0x9d,0x4c,0x21,0xed,0xae,0x82,0xed,0x19)

/**
 * @brief  Event handler
 * @param  Event: Address of the buffer holding the Event
 * @retval Ack: Return whether the Event has been managed or not
 */
static SVCCTL_EvtAckStatus_t Custom_STM_Event_Handler(void *Event)
{
  SVCCTL_EvtAckStatus_t return_value;
  hci_event_pckt *event_pckt;
  evt_blecore_aci *blecore_evt;
  aci_gatt_attribute_modified_event_rp0 *attribute_modified;
  aci_gatt_read_permit_req_event_rp0    *read_req;
  aci_gatt_notification_complete_event_rp0    *notification_complete;
  Custom_STM_App_Notification_evt_t     Notification;
  return_value = SVCCTL_EvtNotAck;
  event_pckt = (hci_event_pckt *)(((hci_uart_pckt*)Event)->data);

  switch (event_pckt->evt)
  {
    case HCI_VENDOR_SPECIFIC_DEBUG_EVT_CODE:
      blecore_evt = (evt_blecore_aci*)event_pckt->data;
      switch (blecore_evt->ecode)
      {
        case ACI_GATT_ATTRIBUTE_MODIFIED_VSEVT_CODE:
          /* USER CODE BEGIN EVT_BLUE_GATT_ATTRIBUTE_MODIFIED_BEGIN */

          /* USER CODE END EVT_BLUE_GATT_ATTRIBUTE_MODIFIED_BEGIN */
          attribute_modified = (aci_gatt_attribute_modified_event_rp0*)blecore_evt->data;
          if (attribute_modified->Attr_Handle == (CustomContext.CustomBawb55Hdle + CHARACTERISTIC_DESCRIPTOR_ATTRIBUTE_OFFSET))
          {
            return_value = SVCCTL_EvtAckFlowEnable;
            switch (attribute_modified->Attr_Data[0])
            {
              /* USER CODE BEGIN CUSTOM_STM_Service_1_Char_1_attribute_modified  */

              /* USER CODE END CUSTOM_STM_Service_1_Char_1_attribute_modified  */

              /* Disabled Notification and Indication management */
              case (!(COMSVC_Notification) | !(COMSVC_Indication)):
                /* USER CODE BEGIN CUSTOM_STM_Service_1_Char_1_Disabled_BEGIN  */

                /* USER CODE END CUSTOM_STM_Service_1_Char_1_Disabled_BEGIN  */
                Notification.Custom_Evt_Opcode = CUSTOM_STM_BAWB55_NOTIFY_DISABLED_EVT;
                Custom_STM_App_Notification(&Notification);
                Notification.Custom_Evt_Opcode = CUSTOM_STM_BAWB55_INDICATE_DISABLED_EVT;
                Custom_STM_App_Notification(&Notification);
                /* USER CODE BEGIN CUSTOM_STM_Service_1_Char_1_Disabled_END */

                /* USER CODE END CUSTOM_STM_Service_1_Char_1_Disabled_END */
                break;

              /* Enabled Notification management */
              case COMSVC_Notification:
                /* USER CODE BEGIN CUSTOM_STM_Service_1_Char_1_COMSVC_Notification_BEGIN */

                /* USER CODE END CUSTOM_STM_Service_1_Char_1_COMSVC_Notification_BEGIN */
                Notification.Custom_Evt_Opcode = CUSTOM_STM_BAWB55_NOTIFY_ENABLED_EVT;
                Custom_STM_App_Notification(&Notification);
                /* USER CODE BEGIN CUSTOM_STM_Service_1_Char_1_COMSVC_Notification_END */

                /* USER CODE END CUSTOM_STM_Service_1_Char_1_COMSVC_Notification_END */
                break;

              /* Enabled Indication management */
              case COMSVC_Indication:
                /* USER CODE BEGIN CUSTOM_STM_Service_1_Char_1_COMSVC_Indication_BEGIN */

                /* USER CODE END CUSTOM_STM_Service_1_Char_1_COMSVC_Indication_BEGIN */
                Notification.Custom_Evt_Opcode = CUSTOM_STM_BAWB55_INDICATE_ENABLED_EVT;
                Custom_STM_App_Notification(&Notification);
                /* USER CODE BEGIN CUSTOM_STM_Service_1_Char_1_COMSVC_Indication_END */

                /* USER CODE END CUSTOM_STM_Service_1_Char_1_COMSVC_Indication_END */
                break;

              default:
                /* USER CODE BEGIN CUSTOM_STM_Service_1_Char_1_default */

                /* USER CODE END CUSTOM_STM_Service_1_Char_1_default */
                break;
            }
          }  /* if (attribute_modified->Attr_Handle == (CustomContext.CustomBawb55Hdle + CHARACTERISTIC_DESCRIPTOR_ATTRIBUTE_OFFSET))*/

          /* USER CODE BEGIN EVT_BLUE_GATT_ATTRIBUTE_MODIFIED_END */
          if(attribute_modified->Attr_Handle ==
             CustomContext.ControlHdle + CHARACTERISTIC_VALUE_ATTRIBUTE_OFFSET) {
            return_value=SVCCTL_EvtAckFlowEnable;
            /* Parse immediately: the event payload is not retained. No ACI call here. */
            Custom_APP_Control(attribute_modified->Attr_Data,
                               attribute_modified->Attr_Data_Length);
          }
/* USER CODE END EVT_BLUE_GATT_ATTRIBUTE_MODIFIED_END */
          break;

        case ACI_GATT_READ_PERMIT_REQ_VSEVT_CODE :
          /* USER CODE BEGIN EVT_BLUE_GATT_READ_PERMIT_REQ_BEGIN */

          /* USER CODE END EVT_BLUE_GATT_READ_PERMIT_REQ_BEGIN */
          read_req = (aci_gatt_read_permit_req_event_rp0*)blecore_evt->data;
          if (read_req->Attribute_Handle == (CustomContext.CustomBawb55Hdle + CHARACTERISTIC_VALUE_ATTRIBUTE_OFFSET))
          {
            return_value = SVCCTL_EvtAckFlowEnable;
            /*USER CODE BEGIN CUSTOM_STM_Service_1_Char_1_ACI_GATT_READ_PERMIT_REQ_VSEVT_CODE_1 */

            /*USER CODE END CUSTOM_STM_Service_1_Char_1_ACI_GATT_READ_PERMIT_REQ_VSEVT_CODE_1*/
            aci_gatt_allow_read(read_req->Connection_Handle);
            /*USER CODE BEGIN CUSTOM_STM_Service_1_Char_1_ACI_GATT_READ_PERMIT_REQ_VSEVT_CODE_2 */

            /*USER CODE END CUSTOM_STM_Service_1_Char_1_ACI_GATT_READ_PERMIT_REQ_VSEVT_CODE_2*/
          } /* if (read_req->Attribute_Handle == (CustomContext.CustomBawb55Hdle + CHARACTERISTIC_VALUE_ATTRIBUTE_OFFSET))*/
          /* USER CODE BEGIN EVT_BLUE_GATT_READ_PERMIT_REQ_END */
          if(read_req->Attribute_Handle ==
             CustomContext.ControlHdle + CHARACTERISTIC_VALUE_ATTRIBUTE_OFFSET) {
            uint8_t status[20];
            return_value=SVCCTL_EvtAckFlowEnable;
            Custom_APP_GetStatus(status);
            /* CONTROL has no notify property; update only its readable value. */
            if(aci_gatt_update_char_value(CustomContext.CustomBaservHdle,
                  CustomContext.ControlHdle, 0, sizeof(status), status)!=BLE_STATUS_SUCCESS) {
              Error_Handler(); /* Fail closed rather than return stale status. */
            }
            aci_gatt_allow_read(read_req->Connection_Handle);
          }
/* USER CODE END EVT_BLUE_GATT_READ_PERMIT_REQ_END */
          break;

        case ACI_GATT_WRITE_PERMIT_REQ_VSEVT_CODE:
          /* USER CODE BEGIN EVT_BLUE_GATT_WRITE_PERMIT_REQ_BEGIN */

          /* USER CODE END EVT_BLUE_GATT_WRITE_PERMIT_REQ_BEGIN */
          /* USER CODE BEGIN EVT_BLUE_GATT_WRITE_PERMIT_REQ_END */

          /* USER CODE END EVT_BLUE_GATT_WRITE_PERMIT_REQ_END */
          break;

		case ACI_GATT_NOTIFICATION_COMPLETE_VSEVT_CODE:
        {
          /* USER CODE BEGIN EVT_BLUE_GATT_NOTIFICATION_COMPLETE_BEGIN */

          /* USER CODE END EVT_BLUE_GATT_NOTIFICATION_COMPLETE_BEGIN */
          notification_complete = (aci_gatt_notification_complete_event_rp0*)blecore_evt->data;
          Notification.Custom_Evt_Opcode = CUSTOM_STM_NOTIFICATION_COMPLETE_EVT;
          Notification.AttrHandle = notification_complete->Attr_Handle;
          Custom_STM_App_Notification(&Notification);
          /* USER CODE BEGIN EVT_BLUE_GATT_NOTIFICATION_COMPLETE_END */

          /* USER CODE END EVT_BLUE_GATT_NOTIFICATION_COMPLETE_END */
          break;
        }

        default:
          break;
      }
      /* USER CODE BEGIN EVT_VENDOR*/

      /* USER CODE END EVT_VENDOR*/
      break; /* HCI_VENDOR_SPECIFIC_DEBUG_EVT_CODE */

      /* USER CODE BEGIN EVENT_PCKT_CASES*/

      /* USER CODE END EVENT_PCKT_CASES*/

    default:
      /* USER CODE BEGIN EVENT_PCKT*/

      /* USER CODE END EVENT_PCKT*/
      break;
  }

  return(return_value);
}/* end Custom_STM_Event_Handler */

/* Public functions ----------------------------------------------------------*/

/**
 * @brief  Service initialization
 * @param  None
 * @retval None
 */
void SVCCTL_InitCustomSvc(void)
{

  Char_UUID_t  uuid;
  tBleStatus ret = BLE_STATUS_INVALID_PARAMS;
  uint8_t max_attr_record;

  /**
   *  Register the event handler to the BLE controller
   */
  SVCCTL_RegisterSvcHandler(Custom_STM_Event_Handler);

  /**
   *          BrathingAnalyzerService
   *
   * Max_Attribute_Records = 1 + 2*1 + 1*no_of_char_with_notify_or_indicate_property + 1*no_of_char_with_broadcast_property
   * service_max_attribute_record = 1 for BrathingAnalyzerService +
   *                                2 for BrathingAnalyzerWB55 +
   *                                1 for BrathingAnalyzerWB55 configuration descriptor +
   *                              = 4
   *
   * This value doesn't take into account number of descriptors manually added
   * In case of descriptors added, please update the max_attr_record value accordingly in the next SVCCTL_InitService User Section
   */
  max_attr_record = 4;

  /* USER CODE BEGIN SVCCTL_InitService1 */
  max_attr_record = 6; /* service + DATA declaration/value/CCCD + CONTROL declaration/value */
/* USER CODE END SVCCTL_InitService1 */

  COPY_BRATHINGANALYZERSERVICE_UUID(uuid.Char_UUID_128);
  ret = aci_gatt_add_service(UUID_TYPE_128,
                             (Service_UUID_t *) &uuid,
                             PRIMARY_SERVICE,
                             max_attr_record,
                             &(CustomContext.CustomBaservHdle));
  if (ret != BLE_STATUS_SUCCESS)
  {
    APP_DBG_MSG("  Fail   : aci_gatt_add_service command: BASERV, error code: 0x%x \n\r", ret);
  }
  else
  {
    APP_DBG_MSG("  Success: aci_gatt_add_service command: BASERV , handle = 0x%04x \n\r", CustomContext.CustomBaservHdle);
  }

  /**
   *  BrathingAnalyzerWB55
   */
  COPY_BRATHINGANALYZERWB55_UUID(uuid.Char_UUID_128);
  ret = aci_gatt_add_char(CustomContext.CustomBaservHdle,
                          UUID_TYPE_128, &uuid,
                          SizeBawb55,
                          CHAR_PROP_READ | CHAR_PROP_NOTIFY,
                          ATTR_PERMISSION_NONE,
                          GATT_NOTIFY_ATTRIBUTE_WRITE | GATT_NOTIFY_WRITE_REQ_AND_WAIT_FOR_APPL_RESP | GATT_NOTIFY_READ_REQ_AND_WAIT_FOR_APPL_RESP,
                          0x10,
                          CHAR_VALUE_LEN_CONSTANT,
                          &(CustomContext.CustomBawb55Hdle));
  if (ret != BLE_STATUS_SUCCESS)
  {
    APP_DBG_MSG("  Fail   : aci_gatt_add_char command   : BAWB55, error code: 0x%x \n\r", ret);
  }
  else
  {
    APP_DBG_MSG("  Success: aci_gatt_add_char command   : BAWB55 , handle = 0x%04x \n\r", CustomContext.CustomBawb55Hdle);
  }

  /* USER CODE BEGIN SVCCTL_Init_Service1_Char1 */
  /* Place holder for Characteristic Descriptors */

  /* USER CODE END SVCCTL_Init_Service1_Char1 */

  /* USER CODE BEGIN SVCCTL_InitCustomSvc_2 */
  /* CONTROL UUID: 0000a002-8e22-4541-9d4c-21edae82ed19 */
  COPY_UUID_128(uuid.Char_UUID_128,0x00,0x00,0xa0,0x02,0x8e,0x22,0x45,0x41,
                0x9d,0x4c,0x21,0xed,0xae,0x82,0xed,0x19);
  ret=aci_gatt_add_char(CustomContext.CustomBaservHdle,
                        UUID_TYPE_128, &uuid, 20,
                        CHAR_PROP_READ | CHAR_PROP_WRITE,
                        ATTR_PERMISSION_NONE,
                        GATT_NOTIFY_ATTRIBUTE_WRITE | GATT_NOTIFY_READ_REQ_AND_WAIT_FOR_APPL_RESP,
                        0x10, CHAR_VALUE_LEN_VARIABLE,
                        &CustomContext.ControlHdle);
  if(ret!=BLE_STATUS_SUCCESS) {
    APP_DBG_MSG("CONTROL creation failed: 0x%x\n", ret);
    Error_Handler();
  }
/* USER CODE END SVCCTL_InitCustomSvc_2 */

  return;
}

/**
 * @brief  Characteristic update
 * @param  CharOpcode: Characteristic identifier
 * @param  Service_Instance: Instance of the service to which the characteristic belongs
 *
 */
tBleStatus Custom_STM_App_Update_Char(Custom_STM_Char_Opcode_t CharOpcode, uint8_t *pPayload)
{
  tBleStatus ret = BLE_STATUS_INVALID_PARAMS;
  switch (CharOpcode)
  {

    case CUSTOM_STM_BAWB55:
      ret = aci_gatt_update_char_value(CustomContext.CustomBaservHdle,
                                       CustomContext.CustomBawb55Hdle,
                                       0, /* charValOffset */
                                       SizeBawb55, /* charValueLen */
                                       (uint8_t *)  pPayload);
      if (ret != BLE_STATUS_SUCCESS)
      {
        APP_DBG_MSG("  Fail   : aci_gatt_update_char_value BAWB55 command, result : 0x%x \n\r", ret);
      }
      else
      {
        APP_DBG_MSG("  Success: aci_gatt_update_char_value BAWB55 command\n\r");
      }
      /* USER CODE BEGIN CUSTOM_STM_App_Update_Service_1_Char_1*/

      /* USER CODE END CUSTOM_STM_App_Update_Service_1_Char_1*/
      break;

    default:
      break;
  }

  return ret;
}

/**
 * @brief  Characteristic update
 * @param  CharOpcode: Characteristic identifier
 * @param  pPayload: Characteristic value
 * @param  size: Length of the characteristic value in octets
 *
 */
tBleStatus Custom_STM_App_Update_Char_Variable_Length(Custom_STM_Char_Opcode_t CharOpcode, uint8_t *pPayload, uint8_t size)
{
  tBleStatus ret = BLE_STATUS_INVALID_PARAMS;
  /* USER CODE BEGIN Custom_STM_App_Update_Char_Variable_Length_1 */

  /* USER CODE END Custom_STM_App_Update_Char_Variable_Length_1 */

  switch (CharOpcode)
  {

    case CUSTOM_STM_BAWB55:
      ret = aci_gatt_update_char_value(CustomContext.CustomBaservHdle,
                                       CustomContext.CustomBawb55Hdle,
                                       0, /* charValOffset */
                                       size, /* charValueLen */
                                       (uint8_t *)  pPayload);
      if (ret != BLE_STATUS_SUCCESS)
      {
        APP_DBG_MSG("  Fail   : aci_gatt_update_char_value BAWB55 command, result : 0x%x \n\r", ret);
      }
      else
      {
        APP_DBG_MSG("  Success: aci_gatt_update_char_value BAWB55 command\n\r");
      }
      /* USER CODE BEGIN Custom_STM_App_Update_Char_Variable_Length_Service_1_Char_1*/

      /* USER CODE END Custom_STM_App_Update_Char_Variable_Length_Service_1_Char_1*/
      break;

    default:
      break;
  }

  /* USER CODE BEGIN Custom_STM_App_Update_Char_Variable_Length_2 */

  /* USER CODE END Custom_STM_App_Update_Char_Variable_Length_2 */

  return ret;
}

/**
 * @brief  Characteristic update
 * @param  Connection_Handle
 * @param  CharOpcode: Characteristic identifier
 * @param  pPayload: Characteristic value
 *
 */
tBleStatus Custom_STM_App_Update_Char_Ext(uint16_t Connection_Handle, Custom_STM_Char_Opcode_t CharOpcode, uint8_t *pPayload)
{
  tBleStatus ret = BLE_STATUS_INVALID_PARAMS;
  /* USER CODE BEGIN Custom_STM_App_Update_Char_Ext_1 */

  /* USER CODE END Custom_STM_App_Update_Char_Ext_1 */

  switch (CharOpcode)
  {

    case CUSTOM_STM_BAWB55:
      /* USER CODE BEGIN Updated_Length_Service_1_Char_1*/

      /* USER CODE END Updated_Length_Service_1_Char_1*/
      ret = Generic_STM_App_Update_Char_Ext(Connection_Handle, CustomContext.CustomBaservHdle, CustomContext.CustomBawb55Hdle, SizeBawb55, pPayload);

      if (ret != BLE_STATUS_SUCCESS)
      {
        APP_DBG_MSG("  Fail   : Generic_STM_App_Update_Char_Ext command, result : 0x%x \n\r", ret);
      }
      else
      {
        APP_DBG_MSG("  Success: Generic_STM_App_Update_Char_Ext command\n\r");
      }
      break;

    default:
      break;
  }

  /* USER CODE BEGIN Custom_STM_App_Update_Char_Ext_2 */

  /* USER CODE END Custom_STM_App_Update_Char_Ext_2 */

  return ret;
}

static tBleStatus Generic_STM_App_Update_Char_Ext(uint16_t ConnectionHandle, uint16_t ServiceHandle, uint16_t CharHandle, uint16_t CharValueLen, uint8_t *pPayload)
{
  tBleStatus ret = BLE_STATUS_INVALID_PARAMS;

  ret = aci_gatt_update_char_value_ext(ConnectionHandle,
                                       ServiceHandle,
                                       CharHandle,
                                       0, /* update type:0 do not notify, 1 notify, 2 indicate */
                                       CharValueLen, /* charValueLen */
                                       0, /* value offset */
                                       243, /* value length */
                                       (uint8_t *)  pPayload);
  if (ret != BLE_STATUS_SUCCESS)
  {
    APP_DBG_MSG("  Fail   : aci_gatt_update_char_value_ext command, part 1, result : 0x%x \n\r", ret);
  }
  else
  {
    APP_DBG_MSG("  Success: aci_gatt_update_char_value_ext command, part 1\n\r");
  }
  /* USER CODE BEGIN Custom_STM_App_Update_Char_Ext_Service_1_Char_1*/

  if (CharValueLen-243<=243)
  {
    ret = aci_gatt_update_char_value_ext(ConnectionHandle,
                                         ServiceHandle,
                                         CharHandle,
                                         1, /* update type:0 do not notify, 1 notify, 2 indicate */
                                         CharValueLen, /* charValueLen */
                                         243, /* value offset */
                                         CharValueLen-243, /* value length */
                                         (uint8_t *)  ((pPayload)+243));
    if (ret != BLE_STATUS_SUCCESS)
    {
      APP_DBG_MSG("  Fail   : aci_gatt_update_char_value_ext command, part 2, result : 0x%x \n\r", ret);
    }
    else
    {
      APP_DBG_MSG("  Success: aci_gatt_update_char_value_ext command, part 2\n\r");
    }
  }
  else
  {
    ret = aci_gatt_update_char_value_ext(ConnectionHandle,
                                         ServiceHandle,
                                         CharHandle,
                                         0, /* update type:0 do not notify, 1 notify, 2 indicate */
                                         CharValueLen, /* charValueLen */
                                         243, /* value offset */
                                         243, /* value length */
                                         (uint8_t *)  ((pPayload)+243));
    if (ret != BLE_STATUS_SUCCESS)
    {
      APP_DBG_MSG("  Fail   : aci_gatt_update_char_value_ext command, part 3, result : 0x%x \n\r", ret);
    }
    else
    {
      APP_DBG_MSG("  Success: aci_gatt_update_char_value_ext command, part 3\n\r");
    }
    ret = aci_gatt_update_char_value_ext(ConnectionHandle,
                                         ServiceHandle,
                                         CharHandle,
                                         1, /* update type:0 do not notify, 1 notify, 2 indicate */
                                         CharValueLen, /* charValueLen */
                                         243+243, /* value offset */
                                         CharValueLen-243-243, /* value length */
                                         (uint8_t *)  ((pPayload)+243+243));
    if (ret != BLE_STATUS_SUCCESS)
    {
      APP_DBG_MSG("  Fail   : aci_gatt_update_char_value_ext command, part 4, result : 0x%x \n\r", ret);
    }
    else
    {
      APP_DBG_MSG("  Success: aci_gatt_update_char_value_ext command, part 4\n\r");
    }
  }
  return ret;
}
